robot-army/ESP_WeatherStation/Draft_layout_1.png

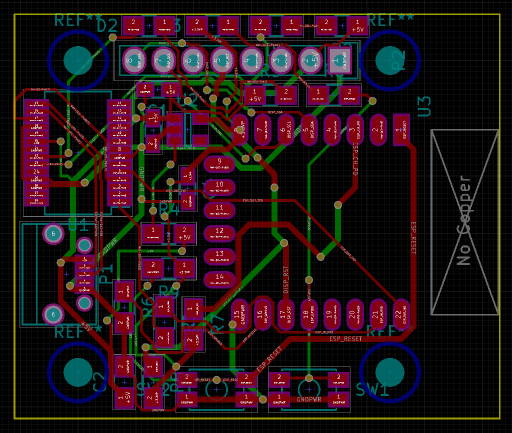
Draft_layout_1.png
