robot-army/ESP_WeatherStation/draft_placement.png

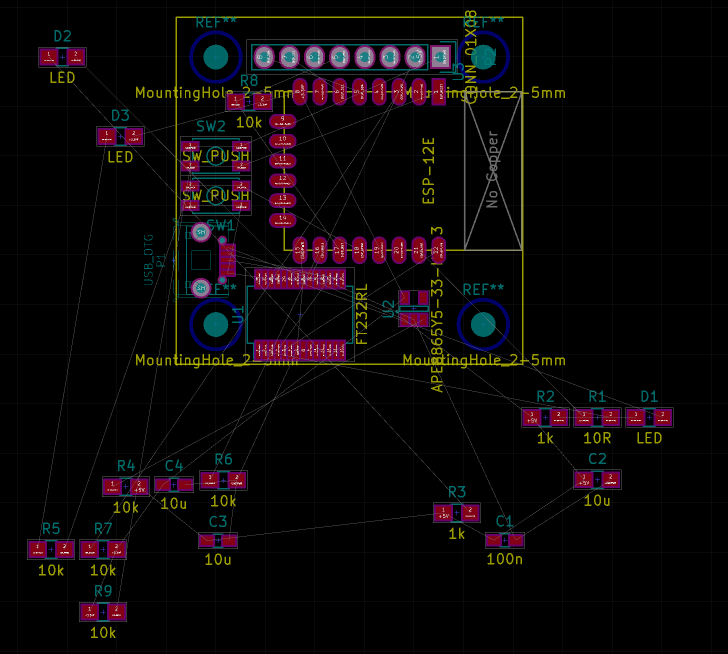
draft_placement.png
