robot-army/ESP_WeatherStation/TechCity2.png

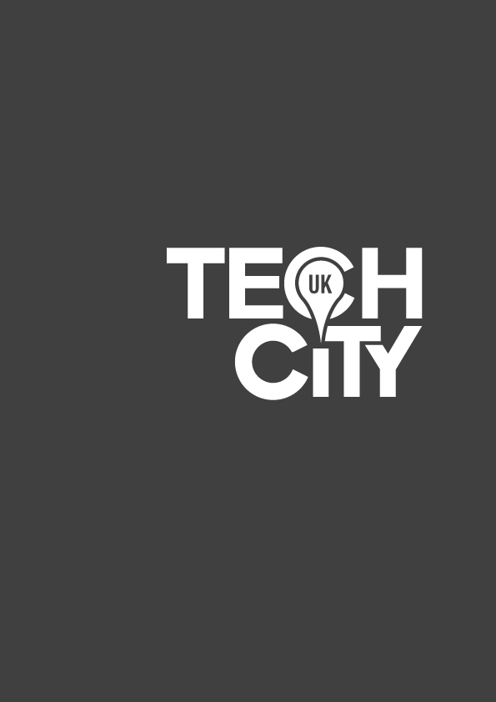
TechCity2.png
