robot-army/ESP_WeatherStation/(threads)

Thread 1 (2015-11-16):

Move tracks away from mounting holes

robot-army, 2015-11-16:
Right hand side top and bottom mounting holes have tracks too close

robot-army, 2015-11-22:
Done

Closed 2015-11-22.

Thread 2 (2015-11-22):

temp sensor too hot - remove found plane?

garytech, 2015-11-22:

robot-army, 2015-11-22:
Yeah, there needs to be a bit more thermal barrier between the sensor and the rest of the module.

Thread 3 (2015-11-22):

mounting holes incorrect

garytech, 2015-11-22:

robot-army, 2015-11-22:
Can you please let me know what the distance between the centres of the actual mounting holes is? I saw it on Adafruit's website as 27 mm, so built around that. (Also, I gave you my whole kit of bits so have no more screens)

Thread 4 (2015-11-22):

break out with pull ups for alternative sensors - i2c + vcc, data, gnd

garytech, 2015-11-22:

robot-army, 2015-11-22:
I'll happily break out I2C on a small connector, I know harwin do some great 1mm pitch wire-to-board connectors, and RS sell pre-crimped wires too.

Thread 5 (2015-11-22):

high frequency noise from screen??

garytech, 2015-11-22:

robot-army, 2015-11-22:
Hmm, acoustic or electrical noise?

There's a missing decoupler near the pins of the screen, try fitting that, or I can do it on the next round of boards

Thread 8 (2015-11-22):

Assign a reasonable minimum passive component size

robot-army, 2015-11-22:
Is a minimum component size of 0805 really necessary when using SOT-23-5 and SOT-23-6 regulators and temperature sensors, not to mention that USB connector?

I'm sure anyone can do 0603 under a microscope with basic training, and I expect that we'll have a microscope and be giving basic training.

Thread 11 (2015-11-24):

this is def an issue - NO STENCIL!!

garytech, 2015-11-24:

robot-army, 2015-11-24:
Unless you can actually solder, then it's fine

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

Closed 2015-11-24.

Thread 12 (2015-11-25):

pin out for cheaper screen?

garytech, 2015-11-25:

robot-army, 2015-11-25:
Can you suggest a cheaper screen?
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

garytech, 2015-11-25:
http://www.ebay.co.uk/itm/Serial-128x64-OLED-LED-Display-Module-Screen-I2C-SPI-Blue-White-LCD-Arduino-/111474769297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

garytech, 2015-11-25:
http://www.ebay.co.uk/itm/Serial-128x64-OLED-LED-Display-Module-Screen-I2C-SPI-Blue-White-LCD-Arduino-/111474769297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

garytech, 2015-11-25:
http://www.ebay.co.uk/itm/Durable-Good-0-96-I2C-IIC-128X64-OLED-LCD-LED-Display-Module-For-Arduino-/390915588511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

garytech, 2015-11-25:
loads....

http://www.ebay.co.uk/sch/i.html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
