robot-army/ESP_WeatherStation/weatherstation.pdf

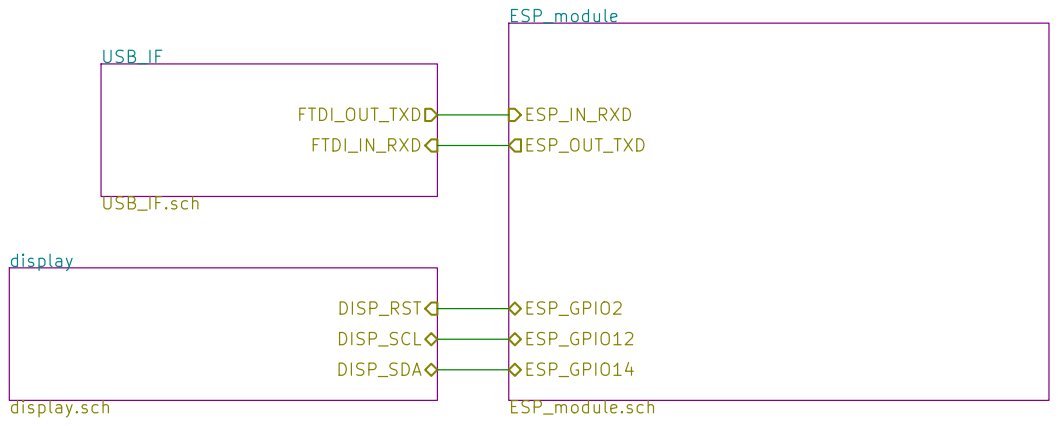
[picture p4: page 1]

Id: 1/4 Title: File: weatherstation.sch Sheet: / USB_IF

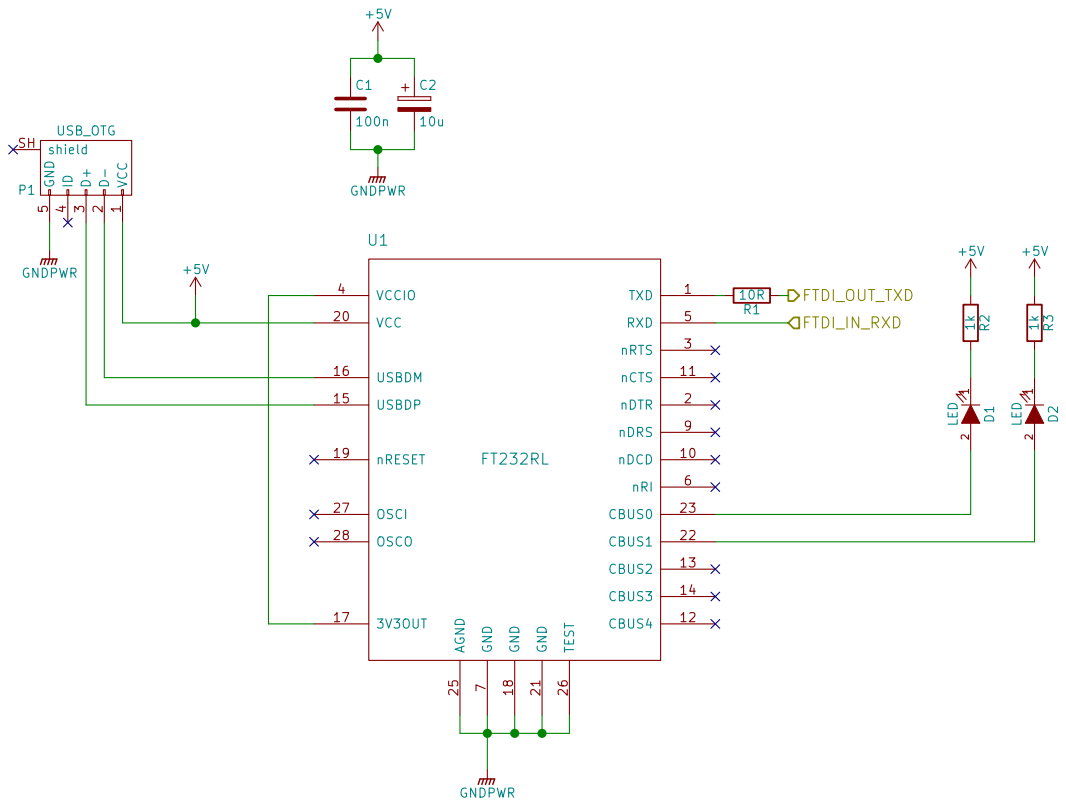
[picture p5: page 2]

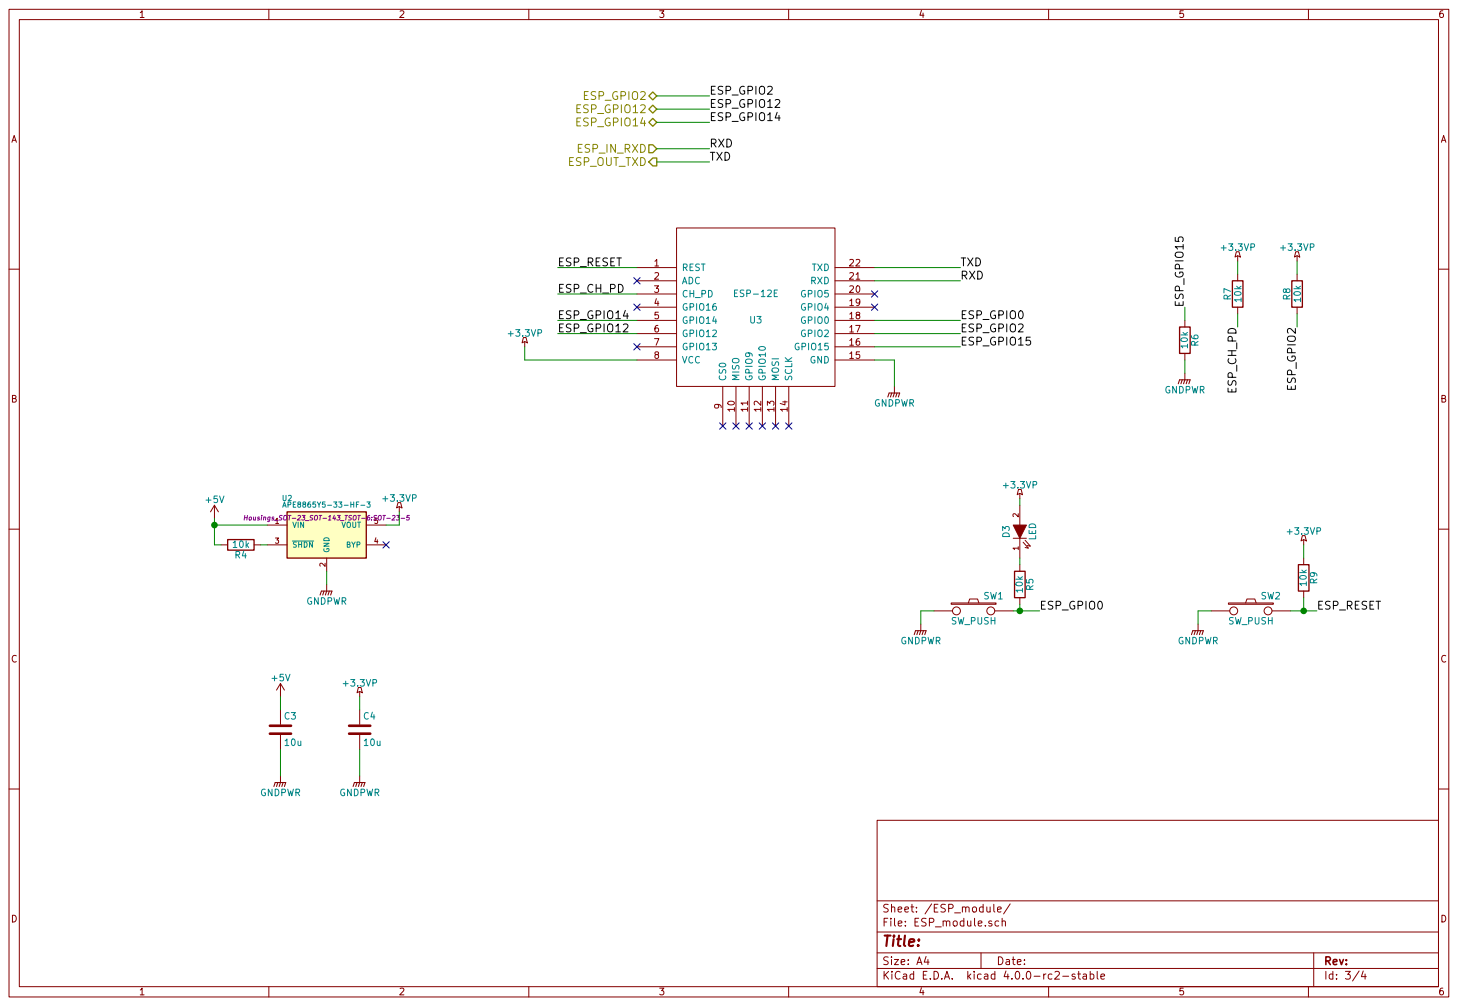
[picture p6: page 3]

2 SHDN 3 BYP 4 VOUT 5 U2APE8865Y5-33-HF-3 Housings_SOT-23_SOT-143_TSOT-6:SOT-23-5 1 2 D3 LED 10k R6 GNDPWR ESP_GPIO15 ESP_GPIO15 ESP_CH_PD R7 10k ESP_CH_PD

9 MISO 10 GPIO5 20 GPIO9 11 RXD 21 GPIO10 12 TXD 22 MOSI 13 SCLK 14 GND 15 GPIO15 16 GPIO2 17 GPIO0 18 GPIO4 19 U3 ESP-12E

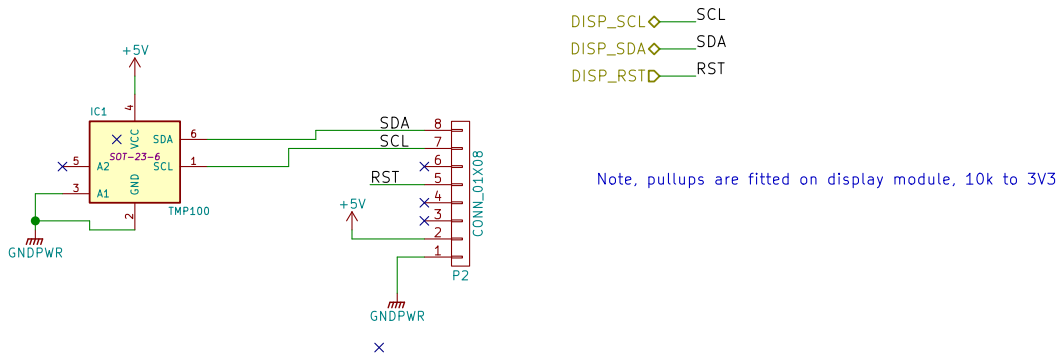
[picture p7: page 4]

Note, pullups are fitted on display module, 10k to 3V3
