robot-army/ESP_WeatherStation/weatherstation.kicad_pcb

## KiCad design weatherstation.kicad_pcb (2016-01-12)

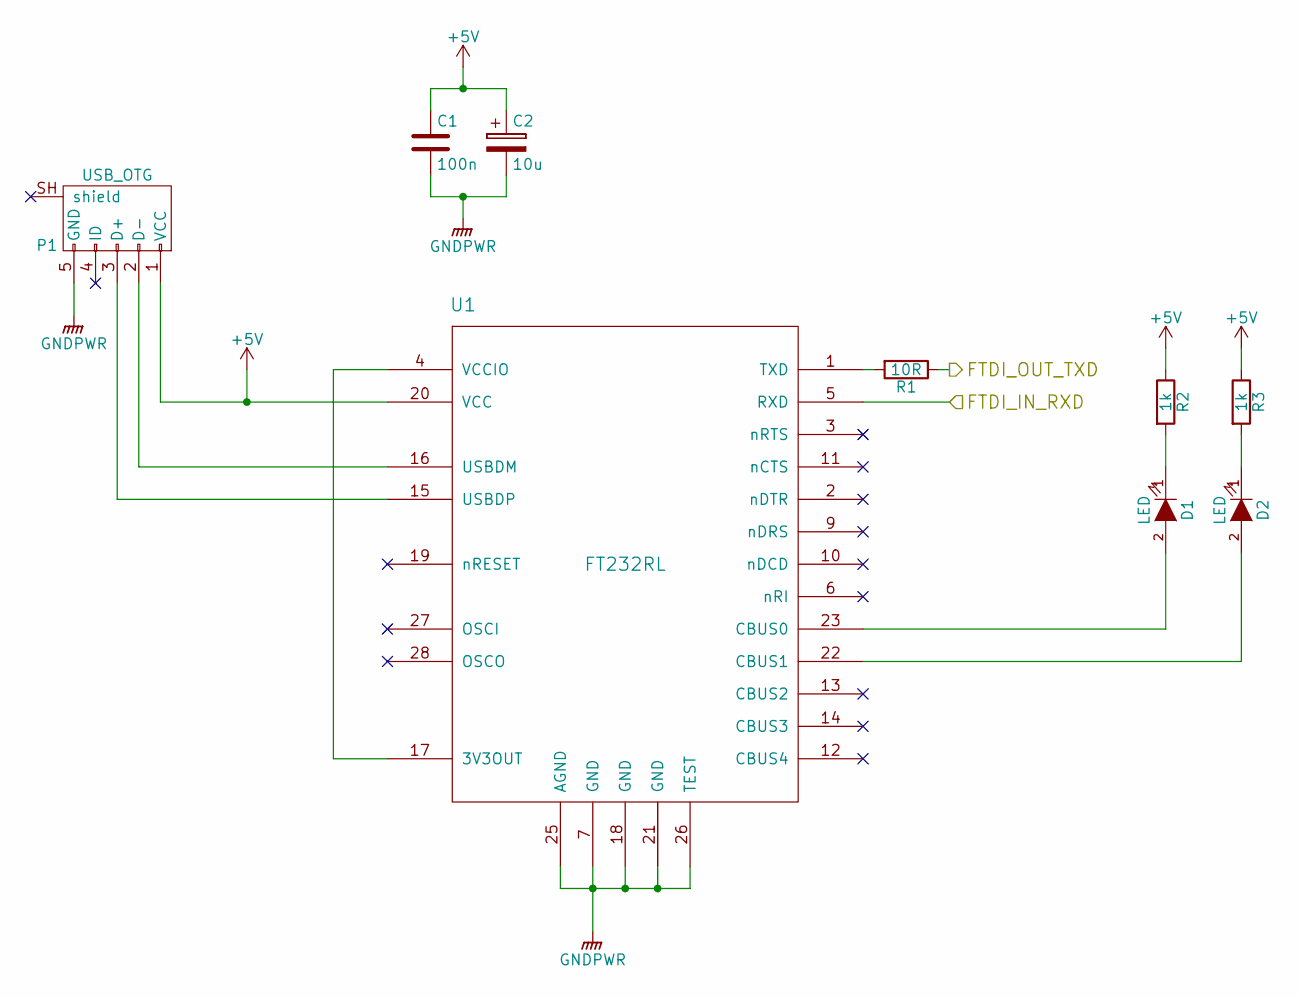
[picture p8: schematic USB_IF.sch]

Parts:
C1: 100n; R_0603_HandSoldering
C2: 10u; R_0805_HandSoldering
D1, D2: LED; R_0805_HandSoldering
P1: USB_OTG; USB_Micro-B
R1: 10R; R_0805_HandSoldering
R2, R3: 1k; R_0805_HandSoldering
U1: FT232RL; SSOP-28_5.3x10.2mm_Pitch0.65mm

Connections:
+5V: C1.1, C2.1, P1.1 (VCC), R2.1, R3.1, U1.20 (VCC); also elsewhere on the board
/ESP_module/ESP_IN_RXD: R1.1; also elsewhere on the board
/ESP_module/ESP_OUT_TXD: U1.5 (RXD); also elsewhere on the board
GNDPWR: C1.2, C2.2, P1.5 (GND), U1.7 (GND), U1.18 (GND), U1.21 (GND), U1.25 (AGND), U1.26 (TEST); also elsewhere on the board
unnamed: D1.1 (K), R2.2
unnamed: D1.2 (A), U1.23 (CBUS0)
unnamed: D2.1 (K), R3.2
unnamed: D2.2 (A), U1.22 (CBUS1)
unnamed: P1.2 (D-), U1.16 (USBDM)
unnamed: P1.3 (D+), U1.15 (USBDP)
unnamed: R1.2, U1.1 (TXD)
unnamed: U1.4 (VCCIO), U1.17 (3V3OUT)

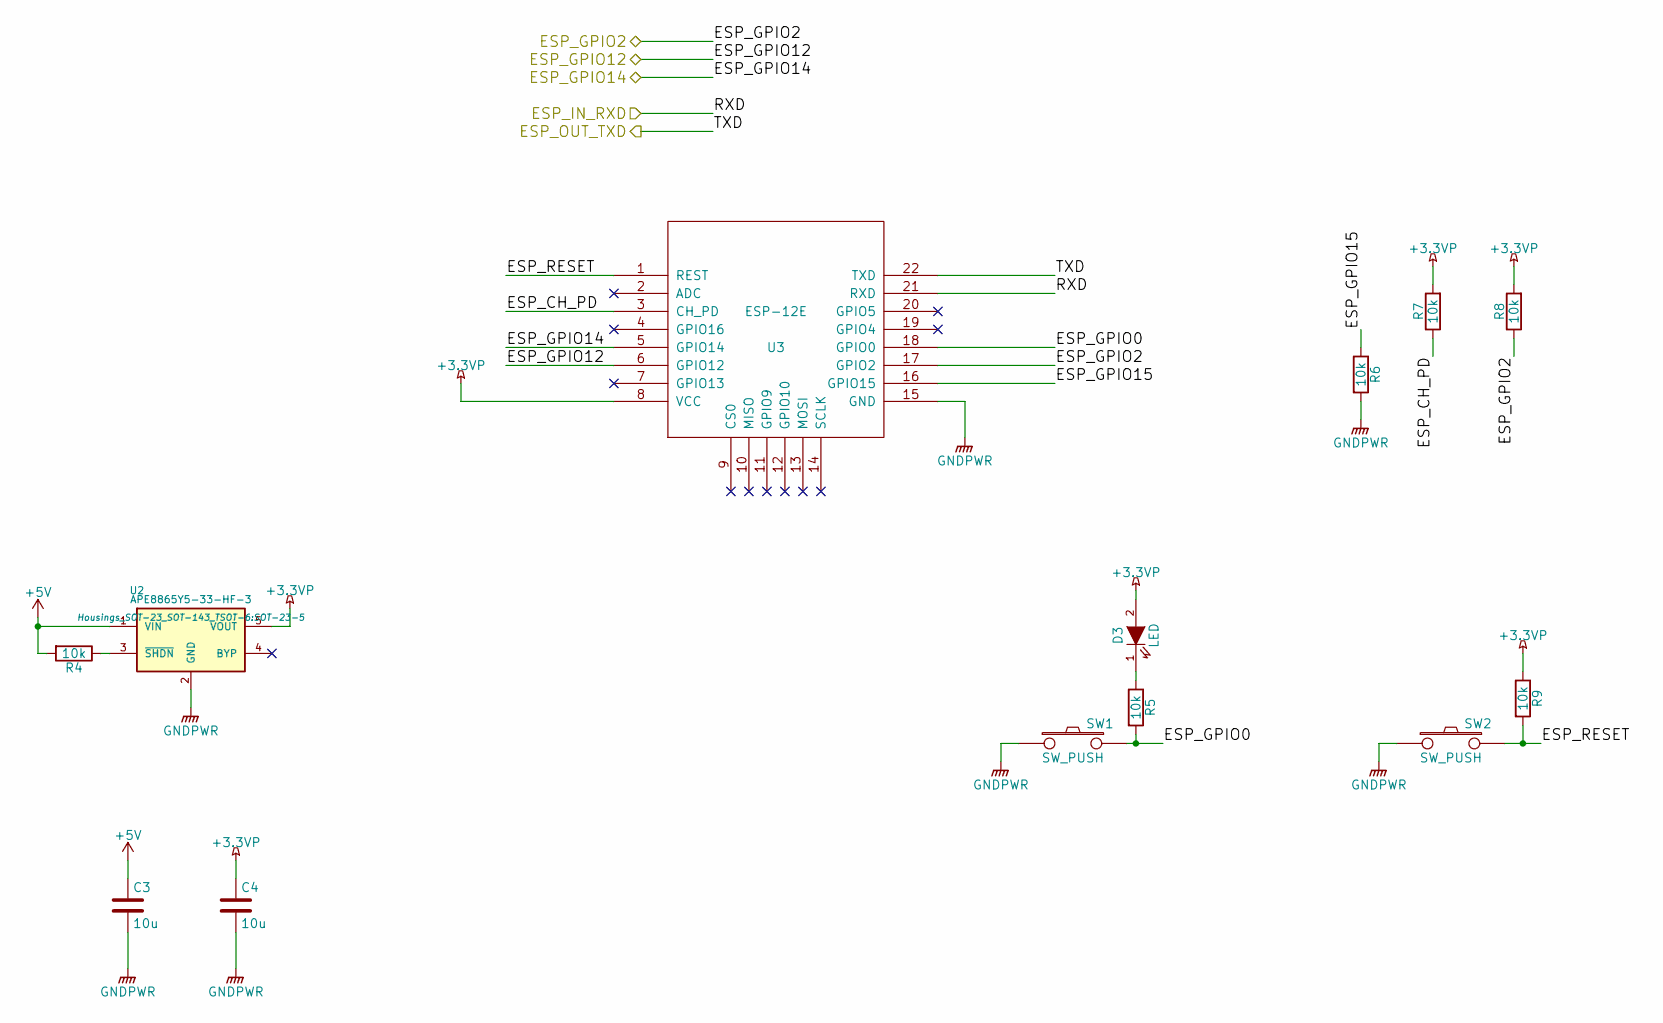
[picture p9: schematic ESP_module.sch]

Parts:
C3, C4: 10u; R_0603_HandSoldering
D3: LED; R_0805_HandSoldering
R4, R5, R6, R7, R8, R9: 10k; R_0805_HandSoldering
SW1, SW2: SW_PUSH; SW_SPST_EVQP2
U2: APE8865Y5-33-HF-3; SOT-23-5
U3: ESP-12E

Connections:
+3.3VP: C4.1, D3.2 (A), R7.2, R8.2, R9.1, U2.5 (VOUT), U3.8 (VCC)
+5V: C3.1, R4.2, U2.1 (VIN); also elsewhere on the board
/ESP_module/ESP_CH_PD: R7.1, U3.3 (CH_PD)
/ESP_module/ESP_GPIO0: R5.2, SW1.2, U3.18 (GPIO0)
/ESP_module/ESP_GPIO15: R6.1, U3.16 (GPIO15)
/ESP_module/ESP_IN_RXD: U3.21 (RXD); also elsewhere on the board
/ESP_module/ESP_OUT_TXD: U3.22 (TXD); also elsewhere on the board
/ESP_module/ESP_RESET: R9.2, SW2.2, U3.1 (REST)
/display/DISP_RST: R8.1, U3.17 (GPIO2); also elsewhere on the board
/display/DISP_SCL: U3.6 (GPIO12); also elsewhere on the board
/display/DISP_SDA: U3.5 (GPIO14); also elsewhere on the board
GNDPWR: C3.2, C4.2, R6.2, SW1.1, SW2.1, U2.2 (GND), U3.15 (GND); also elsewhere on the board
unnamed: D3.1 (K), R5.1
unnamed: R4.1, U2.3 (~SHDN~)

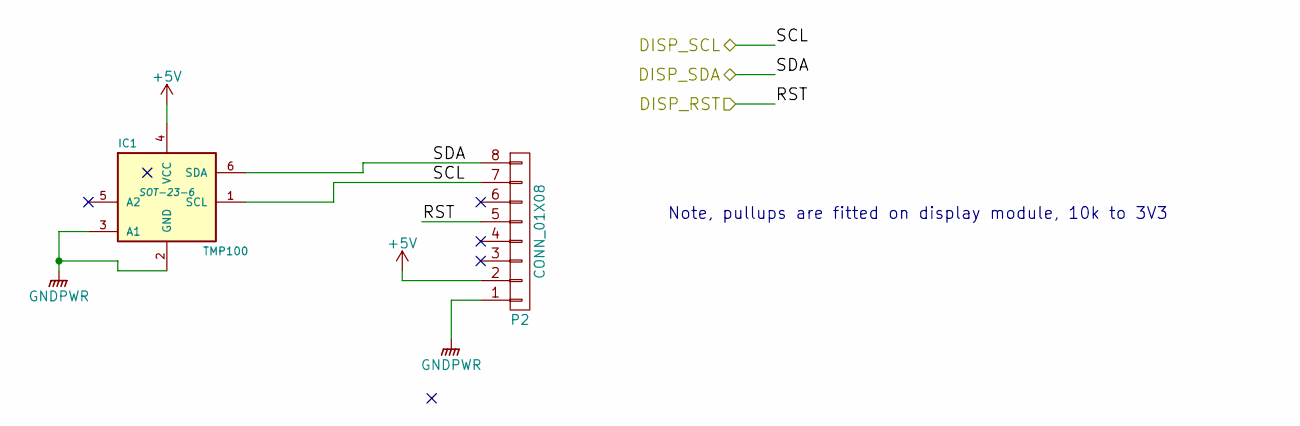
[picture p10: schematic display.sch]

Parts:
IC1: TMP100; SOT-23-6
P2: CONN_01X08; Pin_Header_Straight_1x08

Connections:
+5V: IC1.4 (VCC), P2.2; also elsewhere on the board
/display/DISP_RST: P2.5; also elsewhere on the board
/display/DISP_SCL: IC1.1 (SCL), P2.7; also elsewhere on the board
/display/DISP_SDA: IC1.6 (SDA), P2.8; also elsewhere on the board
GNDPWR: IC1.2 (GND), IC1.3 (A1), P2.1; also elsewhere on the board

Notes on the sheet:
Note, pullups are fitted on display module, 10k to 3V3

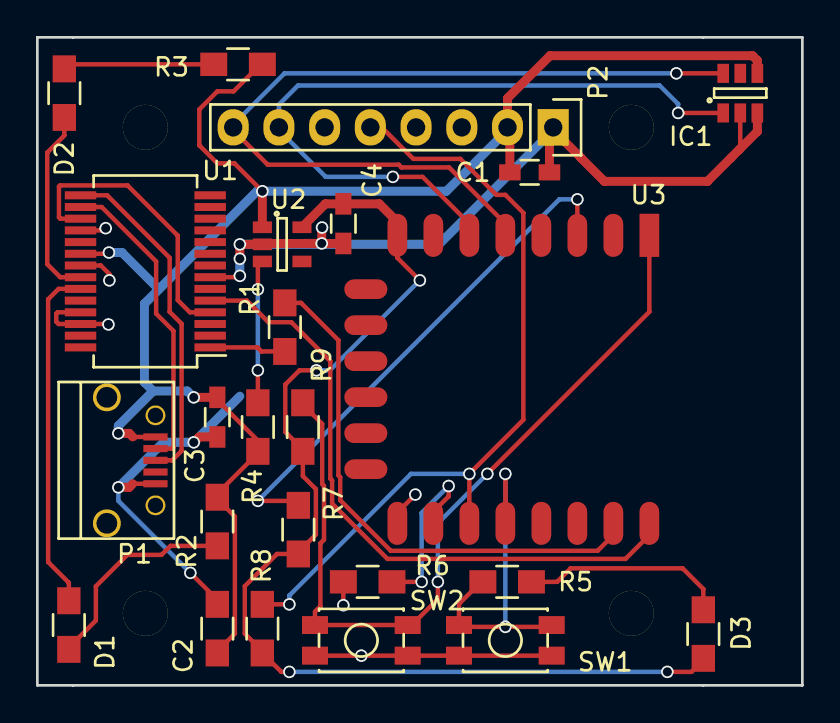
[picture p11: board weatherstation.kicad_pcb from above]

Board: 2 copper layers, 42.5 x 36.0 mm, 24 parts (0 on the bottom side), 22 nets.
