robot-army/ESP_WeatherStation/weather-code/icons.h

/**The MIT License (MIT)

Copyright (c) 2015 by Daniel Eichhorn

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
See more at http://blog.squix.ch
*/

// Weather Icons are from http://www.alessioatzeni.com/meteocons/

#define active_width 8
#define active_height 8
const char active_bits[] PROGMEM = {
   0x00, 0x18, 0x3c, 0x7e, 0x7e, 0x3c, 0x18, 0x00 };

#define inactive_width 8
#define inactive_height 8
const char inactive_bits[] PROGMEM = {
   0x00, 0x18, 0x24, 0x42, 0x42, 0x24, 0x18, 0x00 };
   
const char xbmtemp[] PROGMEM = {
   0x00, 0x00, 0x00, 0x00, 0x00, 0x00, 0x00, 0x00, 0x00, 0x00, 0x00, 0x00,
   0x00, 0x00, 0x00, 0x00, 0x00, 0x00, 0x00, 0x00, 0x00, 0x00, 0x00, 0x00,
   0x00, 0x00, 0x00, 0x00, 0x00, 0x00, 0x00, 0x00, 0x00, 0x00, 0x00, 0x00,
   0x00, 0x00, 0x00, 0x00, 0x00, 0x00, 0x00, 0x00, 0x00, 0x00, 0x00, 0x00,
   0x00, 0x00, 0x00, 0x00, 0x00, 0x00, 0x00, 0x00, 0x00, 0x00, 0x00, 0x00,
   0x00, 0x00, 0x00, 0x00, 0x00, 0x00, 0x00, 0x00, 0x00, 0x00, 0x00, 0x00,
   0x00, 0x00, 0x00, 0x00, 0x00, 0x00, 0x00, 0x00, 0x00, 0x00, 0x00, 0x00,
   0x00, 0x00, 0x00, 0x00, 0x00, 0x00, 0x00, 0x00, 0x00, 0x00, 0x00, 0x00,
   0x00, 0x00, 0x00, 0x00, 0x00, 0x00, 0x00, 0x00, 0x00, 0x00, 0x00, 0xf8,
   0x01, 0x00, 0x00, 0x00, 0x00, 0x00, 0x00, 0xfc, 0x03, 0x00, 0x00, 0x00,
   0x00, 0x00, 0x00, 0x9e, 0x07, 0x00, 0x00, 0x00, 0x00, 0x00, 0x00, 0x0e,
   0x07, 0x00, 0x00, 0x00, 0x00, 0x00, 0x00, 0x06, 0x06, 0x00, 0x00, 0x00,
   0x00, 0x00, 0x00, 0x06, 0x06, 0x00, 0x00, 0x00, 0x00, 0x00, 0x00, 0x06,
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
   0x7f, 0x00, 0xf0, 0x07, 0x00, 0xc0, 0x3f, 0x00, 0xfe, 0xff, 0xff, 0x07,
   0x7c, 0x7e, 0x3c, 0x80, 0x7f, 0x00, 0xf0, 0x07, 0x00, 0xc0, 0x3f, 0x00,
   0xfe, 0xff, 0xff, 0x07, 0x70, 0x7c, 0x1e, 0x80, 0x7f, 0x00, 0xf0, 0x07,
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
