robot-army/ESP_WeatherStation/weather-code/WeatherClient.cpp

/**The MIT License (MIT)

Copyright (c) 2015 by Daniel Eichhorn

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
See more at http://blog.squix.ch
*/

#include "WeatherClient.h"
#include <ESP8266WiFi.h>

void WeatherClient::updateWeatherData(String domainName, String apiKey, double lat, double lon) {
  WiFiClient client;
  const int httpPort = 80;

  Serial.print("Connecting to server: ");
  Serial.println(domainName);
  
  // connnect to our server
  while (!client.connect(domainName.c_str(), httpPort)) {
    Serial.println("connection failed, retrying...");
    delay(10000);
  }
  
  // We now create a URI for the request
  String url = "http://" + domainName + "/weather.php?apiKey=" + apiKey + "&lat=" + String(lat) + "&lon=" + String(lon) + "&units=" + myUnits;

  Serial.print("Requesting URL: ");
  Serial.println(url);
  
  // This will send the request to the server
  client.print(String("GET ") + url + " HTTP/1.1\r\n" +
               "Host: YOURDOMAINNAME\r\n" + 
               "Connection: close\r\n\r\n");

  // wait for response from server
  while(!client.available()) {
    
    delay(200); 
  }
  
  // Read all the lines of the reply from server and print them to Serial
  while(client.available()){
    String line = client.readStringUntil('\n');
    //Serial.println(line);
    String key = getKey(line);
    if (key.length() > 0) {
      String value = getValue(line);
        if (key=="CURRENT_TEMP") {
         currentTemp = value.toInt();
        } else if(key =="CURRENT_HUMIDITY") {
         currentHumidity = value.toInt();
        } else if (key =="CURRENT_ICON") {
         currentIcon = value;
        } else if (key =="CURRENT_SUMMARY") {
         currentSummary = value;
        } else if (key =="MAX_TEMP_TODAY") {
         maxTempToday = value.toInt();
        } else if (key =="MIN_TEMP_TODAY") {
         minTempToday = value.toInt();
        } else if (key =="ICON_TODAY") {
         iconToday = value;
        } else if (key =="SUMMARY_TODAY") {
         summaryToday = value;
        } else if (key =="MAX_TEMP_TOMORROW") {
         maxTempTomorrow = value.toInt();
        } else if (key =="ICON_TOMORROW") {
         iconTomorrow = value;
        } else if (key =="MIN_TEMP_TOMORROW") {
         minTempTomorrow = value.toInt();
        } else if (key =="SUMMARY_TODAY") {
         summaryTomorrow = value;
        } 

    }
    
  }
  
  
  Serial.println();
  Serial.println("closing connection");    
}

void WeatherClient::setUnits(String units) {
   myUnits = units; 
}

String WeatherClient::getKey(String line) {
  int separatorPosition = line.indexOf("=");
  if (separatorPosition == -1) {
    return "";
  }  
  return line.substring(0, separatorPosition);
}

String WeatherClient::getValue(String line) {
  int separatorPosition = line.indexOf("=");
  if (separatorPosition == -1) {
    return "";
  }  
  return line.substring(separatorPosition + 1);
}


int WeatherClient::getCurrentTemp(void) {
  return currentTemp;
}
int WeatherClient::getCurrentHumidity(void) {
  return currentHumidity;
}
String WeatherClient::getCurrentIcon(void) {
  return currentIcon;
}
String WeatherClient::getCurrentSummary(void) {
  return currentSummary;
}
String WeatherClient::getIconToday(void) {
  return iconToday;
}
int WeatherClient::getMaxTempToday(void) {
  return maxTempToday;
}
int WeatherClient::getMinTempToday(void) {
  return minTempToday;
}
String WeatherClient::getSummaryToday(void) {
  return summaryToday;
}
int WeatherClient::getMaxTempTomorrow(void) {
  return maxTempTomorrow;
}
int WeatherClient::getMinTempTomorrow(void) {
  return minTempTomorrow;
}
String WeatherClient::getIconTomorrow(void) {
  return iconTomorrow;
}
String WeatherClient::getSummaryTomorrow(void) {
  return summaryTomorrow;
}
