robot-army/ESP_WeatherStation/(commit log)

2015-11-09 Added root and hierarchical schematics, cache and mostly blank board
    [ESP_module.sch, USB_IF.sch, display.sch, weatherstation.kicad_pcb, weatherstation.sch]
2015-11-10 Started adding component values and tidying up
    [ESP_module.sch, USB_IF.sch, weatherstation.sch]
2015-11-10 added component values and most packages. Still missing micro usb
    [ESP_module.sch, USB_IF.sch, display.sch]
2015-11-10 Added a USB socket with GND set as a power output to pass DRC, and gave a first stab at a placement. Man that's tight! Components both side required??
    [ESP_module.sch, USB_IF.sch, display.sch, weatherstation.kicad_pcb]
2015-11-16 Dodgy layout added, etc
    [ESP_module.sch, USB_IF.sch, display.sch, weatherstation.kicad_pcb, weatherstation.sch]
2015-11-16 Added some RS part numbers for switches and usb
    [ESP_module.sch, USB_IF.sch, display.sch, weatherstation.sch]
2015-11-16 Added some RS part numbers
    [ESP_module.sch, USB_IF.sch, display.sch, weatherstation.sch]
2015-11-16 Added first layout with all tracks routed. Bit ugly, needs logo and sensor added
2015-11-16 Fixed layout up a bit
    [weatherstation.kicad_pcb]
2015-11-16 Added logo, sensor, manufacturing data'
    [ESP_module.sch, USB_IF.sch, display.sch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]
2015-11-16 Fixed track too close to FTDI chip
    [weatherstation-B.Cu.gbr, weatherstation-B.Mask.gbr, weatherstation-B.SilkS.gbr, weatherstation-Dwgs.User.gbr, weatherstation-Edge.Cuts.gbr, weatherstation-F.Cu.gbr, weatherstation-F.Mask.gbr, weatherstation-F.SilkS.gbr]
2015-11-16 Added BOM with RS numbers
    [weatherstation.csv, weatherstation.kicad_pcb]
2015-11-16 added svg of board
2015-11-17 Added manufacturing files, fixed rear text, moved tracks away from mounting holes and added vias to ground plane
    [weatherstation-B.Cu.gbr, weatherstation-B.Mask.gbr, weatherstation-B.SilkS.gbr, weatherstation-Dwgs.User.gbr, weatherstation-Edge.Cuts.gbr, weatherstation-F.Cu.gbr, weatherstation-F.Mask.gbr, weatherstation-F.SilkS.gbr]
2015-11-22 Arduino Code Init
2015-11-22 costs on mom
    [weatherstation.csv]
2016-01-12 Fixed libarary paths
    [weatherstation.kicad_pcb]
